rohitvijayakumar45/ShelfFlow/reports/cam-640x480-final.jpg

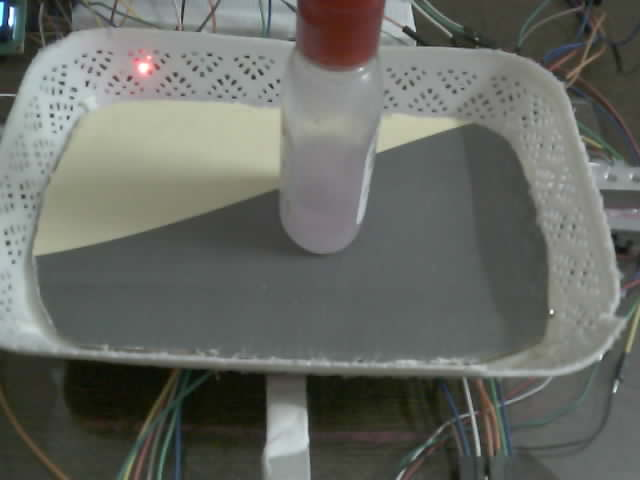
reports/cam-640x480-final.jpg
