rohitvijayakumar45/ShelfFlow/reports/cam-perfboard.jpg

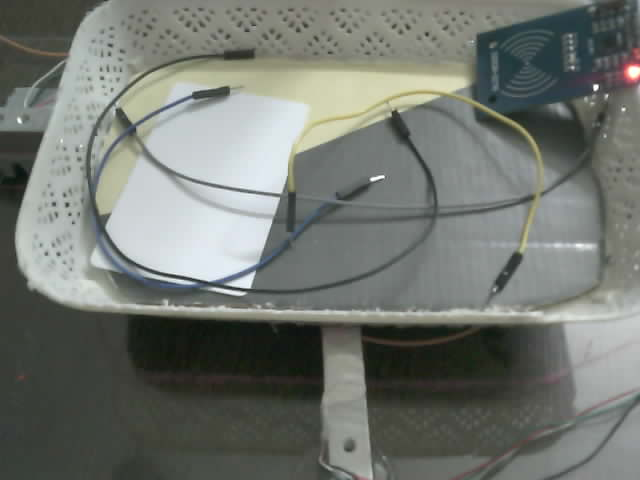
reports/cam-perfboard.jpg
