rohitvijayakumar45/ShelfFlow/firmware/gate-controller/include/README.md

Copy ../../common/Secrets.example.h here as secrets.h. Gate mechanism, voltage levels, actuator supply and feedback must be inspected before connection.
