rohitvijayakumar45/ShelfFlow/firmware/shelf-controller/include/README.md

Copy ../../common/Secrets.example.h here as secrets.h and configure credentials. This file contains no real credentials. The separate proposed controller mapping is documented in docs/wiring.md.
