rohitvijayakumar45/ShelfFlow/requirements-gpu.txt

# Install into the project venv with pip -r requirements-gpu.txt.
# Official Windows CUDA 12.8 wheels; run tools.dataset.gpu_check after installation.
--index-url https://download.pytorch.org/whl/cu128
torch==2.10.0+cu128
torchvision==0.25.0+cu128
