rohitvijayakumar45/ShelfFlow/docs/HANDOFF-2026-10-26.md

# Handoff: 26 October 2026 (night session, Aditya's laptop)

Read this first, then [HANDOFF-2026-10-25-laptop2.md](HANDOFF-2026-10-25-laptop2.md) (setup, hardware, start
commands) and [HANDOFF.md](HANDOFF.md) (hardware, weighing, camera history). Passwords, Wi-Fi keys and device keys
are **not** in git; the user has them in a separate file (`ShelfFlow-secrets-2026-10-26.txt`, kept outside the repo).

## Rules the user set (keep following them)

- **Do not change hardware/firmware/load-cell/RFID code. Do not flash anything without telling the user first.**
- The user does everything through the **staff (5174) and customer (5173) websites, never the terminal**. Claude
  starts/restarts services itself (from the `ShelfFlow` folder, not its parent) and checks they answer.
- **Never restart the trainer while a SAM/YOLO job runs.** Check `/status` of the trainer (port 8001) first.
- Answer fast and plainly; do not guess ("don't hallucinate"); change code only when asked.
- Installs stay inside the project folder; big downloads resumable + hash-checked.

## State when this session stopped

- Tests: **241 passed** (`.\.venv\Scripts\python.exe -m pytest -q`). Both apps build (`cd apps; node build.mjs`).
- Running services (terminal tabs): backend, camera_preview, usb_bridge (COM7), trainer, detector_preview,
  weight_monitor, camera_watch. **The vision service (`tools.local_app vision`) was NOT running** at the end; it
  stopped by itself earlier. Start it again with `.\.venv\Scripts\python.exe -m tools.local_app vision`.
- No training job running. Last run `20261026-005450` finished.

### Trained models (Train products page, YOLO26n, chained)

Each run builds on the one before it (parent = model in use) and keeps its products:

| Run | Knows | Parent |
|---|---|---|
| 20261025-234004 | sanitizer | (fresh start) |
| 20261025-235955 | + vicks | 234004 |
| 20261026-000926 | + sunscreen | 235955 |
| 20261026-002045 | + hair-care (Hair Wax) | 000926 |
| 20261026-003817 | + powder (Banana Powder) | 002045 |
| **20261026-005450 (in use)** | + nose-drops (Nose Drops): 6 products, mAP50 99.5 % | 003817 |

Recordings (all LABELLED): empty tray (81 frames), sanitizer, vicks, sunscreen, hair-care, powder, nose-drops.
Catalogue (store DB): sanitizer, vicks, sunscreen, hair-care, powder, nose-drops (Nose Drops was added this session).
**Models, recordings and the database are git-ignored** (`models/`, `data/`): they exist only on this laptop
(`models/` 289 MB, `data/` 3 GB incl. `data/training` 189 MB). Back them up by copying those folders.

The validation mAP is optimistic (val frames come from the same clips). Real check: Train page → Test live.

## What was built this session (all in this commit)

1. **Model lineage** (`vision/training.py`, `tools/trainer.py`): a new run inherits the dataset frames and weights
   of the model in use, so it always knows every product trained before, even if their recordings are deleted.
   `POST /train` takes `parent` ("" = fresh). Train page shows "Builds on the model in use, which knows … Adds …".
   **Stop using** button (`POST /runs/{id}/deactivate`) lets you delete the model in use and start from scratch.
   Epochs: free number input (1–300). Training stops early on its own (patience ≈ epochs/3, ≥ 10); Stop keeps the best.
2. **Unknown check** (`vision/verify.py`): every YOLO detection is compared (DINOv2 cosine similarity) with reference
   crops of the product YOLO named, cut from that model's own training frames; too dissimilar → UNKNOWN.
   References are built automatically at the end of each training (`run/best-refs.npz`) and copied to
   `models/trained/active-refs.npz` on "Use this model" (built on the spot for older runs). Per-product threshold =
   5th percentile of the product's own validation similarity, clamped to [0.55, 0.75]. Used in the live view
   (`tools/detector_preview.py`), Test live (`tools/trainer.py`) and the shop (`vision/run.py`, averaged per track
   via `TrackCheck`). No references file → no check (old behaviour). Measured on the sanitizer-only model:
   own frames kept 47/50; old-camera Vicks 51/59 and Sunscreen 58/59 rejected.
3. **Earlier-system import** (`tools/import_pilot_training.py`): turns `data/shelf-pilot` (16 Oct hand-labelled
   frames of sanitizer/vicks/sunscreen + 25 Oct empty-tray frames) into Train-page recordings. The user later
   deleted those imported recordings and retrained everything from their own clips; the tool stays for reuse.
4. **Full shop workflow, part 1** (tested, NOT yet switched on):
   - **Strict auto-add** (`backend/config.py` `AUTO_ADD`, `backend/service.py` `timely_weight_source`): in hardware
     mode a camera event may update the cart without staff review when it cites exactly one shelf WEIGHT event
     that the laptop received during the camera window (stands in for the shelf's second-accurate clock), AND every
     existing fusion check passes (one owner via bracelet marker, hand-product-trajectory chain, weight matches a
     unit, vision agrees with weight, stock, single-use sensor evidence, two-shopper ambiguity → review).
     Off by default; needs `AUTO_ADD=true` and `WEIGHTS_ENABLED=true` in `data/integration/runtime.env` + backend restart.
     Tests: `backend/tests/test_auto_add.py`.
   - **Bracelet bands as identity** (`vision/hands.py` `split_bands`, `band_evidence`; wired in `vision/run.py`):
     YOLO classes `band-stripe` / `band-circle` are removed from the product list and become bracelet markers
     **200 (Stripes)** / **201 (Circles)**; the area around a band (3× its box, `band_hand_reach` in vision-config)
     acts as that wrist's hand. Existing marker → bracelet → session mapping then names the customer.
     Tests: `vision/tests/test_bands.py`.
   - **Sensor health**: the controller reports `ok=false` forever once its queue overflowed since boot (historical
     count, 67 at the end). Vision now treats the sensor as healthy unless that count grows during a pickup or
     there are fault flags (`SENSOR_QUEUE_LOST_EVENTS`). A controller reset (RST button, not a flash) clears it.
   - **Check-in** (`POST /staff/check-in/preview`, `POST /staff/check-in`; staff app Shoppers & checkout →
     Check-in & bracelets): scan the customer's entry QR → tap the bracelet on a shelf RFID reader → "Assign and
     start visit". Consumes the QR once, refuses unregistered / busy / pattern-less bracelets, one bracelet per visit.
   - **Bracelet register** form with pattern (Stripes/Circles) and "Use latest tap"; table shows pattern + wearer.
     The old dispenser/manual assignment moved into a collapsed "Bracelet dispenser (simulated gate)" panel.
   - **Train page**: "Bracelet with stripes" / "Bracelet with circles" in "What are you recording?" (classes
     band-stripe / band-circle; never charged).
   - **Staff exit backend** (`POST /staff/exit`, `GET /staff/visits/{id}`, `service.staff_exit`): one payment key per
     visit (`exit-<session>`), so repeats return the same bill; blocked while pickup/return events are pending.
     Customer cart now includes the bracelet's markers.

## NOT finished (next steps, in order)

1. **Exit screen in the staff app and customer "go to the exit" text**: written but NOT applied. Apply with
   `.\.venv\Scripts\python.exe docs\pending\exit-checkout-ui-patch.py` from the ShelfFlow folder, then
   `cd apps; node build.mjs`. Check the `fetch('/api/staff/visits/…')` URL matches how the staff app proxies the
   backend (other calls use `/api/...`); then delete `docs/pending/`.
2. **Register the bracelets**: only B01 (tag `43D51829`, state RETURNED, no pattern) exists. Staff app →
   Shoppers & checkout → Bracelet inventory → Register or relabel: B01 = one pattern, B02 = the other (tap it, "Use
   latest tap"), Cleaned ticked.
3. **Train the bands** on the Train page (user planned this): record each bracelet worn on a hand moving over the
   tray, mark it, Train (builds on the 6-product model), Use this model. Check in the live view that bands are boxed.
4. **Unit weights / stock**: tray-a is unit-tracked; every product still has no measured weight and stock is 0.
   Load units with the tray-loading wizard (Shelf setup) so each unit's weight is recorded.
5. **Switch on**: `WEIGHTS_ENABLED=true`, `AUTO_ADD=true` in runtime.env, restart backend and vision; then a full
   physical trial: check-in → pickup → cart + stock update → return → exit → bill → bracelet return.
   Tune `band_hand_reach` if pickups are not linked to the band.
6. Exit is "staff check-out" (user's choice); there is no exit hardware. Payment stays SIMULATED (no provider).
7. Two shoppers on one tray: weight-driven path only links a band when exactly one item track moved; otherwise the
   event goes to review (by design, never charge an arbitrary customer).
8. Clean-up: review queue items; old junk runs were already deleted by the user.

## Camera problems (to troubleshoot next, user's request)

- **Short drops**: `tools.camera_watch` (log `data/logs/camera-watch.jsonl`) saw the camera vanish for ~9 s about
  every 10–30 min (22:47 → 01:08, 14 times), every time "STAYED RUNNING, was off the network" (uptime kept growing),
  i.e. Wi-Fi/hotspot drops, not reboots/brownouts.
- **Start-up failures** (intermittent, earlier): see HANDOFF.md section 8 and the 25 Oct laptop2 handoff. The COM9
  brownout loop is most likely the **programmer** board, not the camera. Fit the 100 µF capacitor at the camera
  5V/GND; read the camera's own boot log with EN→GND on the programmer: `tools.camera_serial_log --port COM9`.
- **Add the Pixel hotspot** as a second network (firmware already rotates through up to 3 SSIDs every 15 s):
  needs (a) a short PlatformIO path (junction `C:\pio` → `.platformio-core`, `PLATFORMIO_CORE_DIR=C:\pio`; long
  paths exceed Windows' command-line limit), (b) `WIFI_SSID_2 "Pixel"` / `WIFI_PASSWORD_2` in
  `firmware/camera/include/secrets.h` (keep CAMERA_KEY unchanged; values in the user's secrets file),
  (c) programmer EN→GND jumper, hold camera IO0→GND while tapping RST, (d) `esptool read_mac` must show
  `68:09:47:F8:93:B8` before upload. **Tell the user before flashing.**

## Hardware/network quick facts

Hotspot **X200T** (laptop + camera). Camera `10.12.94.251`, MAC `68:09:47:F8:93:B8`, OV3660, 320×240 ~11 fps.
Shelf controller **COM7**, programmer **COM9**. Tray-a calibration `ac2-167a4d-8q`. GPU RTX 4050, CUDA torch 2.10.

## Files outside git the next session needs (all on this laptop)

`data/integration/runtime.env` (+ `.old-system`), `data/integration/vision-config.json`, `data/integration/store.db`,
`.env`, `firmware/camera/include/secrets.h` + `board_config.h`, `firmware/shelf-controller/include/secrets.h`,
`models/` (trained models, references, YOLO/SAM weights), `data/training/` (recordings and runs),
`data/hardware-backups/`, `handoff-secrets/` (copies of the secret files; never commit it).
Their secret contents are in the user's secrets file.

## Moving to a new system (checklist)

1. `git clone` / pull `main`. Unzip `ShelfFlow-local-data-2026-10-26.zip` into the ShelfFlow folder (adds `models/`,
   `data/`, `evidence/`, `shelfflow.db`, `.env`, `handoff-secrets/`, firmware `secrets.h` / `board_config.h`).
   Replace `data/integration/store.db` with `ShelfFlow-store-snapshot-2026-10-26.db` (consistent copy).
2. Edit the absolute paths in `data/integration/runtime.env` to the new folder.
3. Reinstall what is not copied (see HANDOFF-2026-10-25-laptop2.md "Setup"): `.venv` with `pip install -e .[test,vision,hardware]`
   (+ CUDA PyTorch if there is an NVIDIA GPU), `cd apps; npm install`, PlatformIO only if firmware must be built.
4. Needs internet once: the Unknown check downloads `facebook/dinov2-small` (~90 MB) into the Hugging Face cache
   (outside the project) on first use.
5. COM ports differ per machine: find the shelf controller's port and pass it to `tools.usb_bridge --port`.
   The laptop must join hotspot X200T to reach the camera at 10.12.94.251.
6. Start the services (commands in HANDOFF-2026-10-25-laptop2.md) and check the Train page shows run
   20261026-005450 as "in use" with 6 products.
