rohitvijayakumar45/ShelfFlow/docs/audit-2026-10-12.md

# Requirements audit — 12 October 2026

Scope: the whole repository at commit `1d0e93c` plus the fixes listed below, checked against the
original ShelfFlow specification (sections 1–14). Hardware context: one ESP32-S camera board with
OV3660, one ordinary ESP32 used as the programmer instead of a USB-TTL adapter, and one RC522.

Legend: **PASS** = implemented and exercised by automated tests or builds in this audit.
**PARTIAL** = implemented, but a stated part is missing or only simulated. **OPEN** = requires physical
hardware or data that does not exist yet. Nothing here is physically verified.

## What was re-run in this audit

| Check | Result |
|---|---|
| `pytest` (backend + vision) | **68 passed** (66 existing + 2 new regression tests), 1 third-party deprecation warning |
| `firmware/programmer` build | SUCCESS |
| `firmware/shelf-controller` build | SUCCESS (RAM 45,736 B, flash 856,337 B) |
| `firmware/gate-controller` build | SUCCESS |
| `firmware/camera` — `unconfigured-diagnostic`, `camera-api-check` | SUCCESS |
| `firmware/camera` — new `esp32cam-identify`, `esp32cam-pinmap-probe`, `esp32cam` | SUCCESS |
| Real camera server built for `esp32cam` with candidate map as a temporary `board_config.h` | SUCCESS (flash 859,393 B), temp file removed |
| Generated camera upload command | Verified: `--baud 115200 --before no_reset --after no_reset`, offsets 0x1000/0x8000/0xe000/0x10000 |
| `import vision.run, vision.benchmark` | OK |
| Docker Compose, PostgreSQL, Mosquitto, RQ | **Not run** — Docker unavailable (unchanged from status.md) |
| Any flashing, wiring, sensor reading | **Not done** — no hardware attached to this PC |

## Defects found and fixed

| # | Severity | Finding | Fix | Verification |
|---|---|---|---|---|
| F1 | High | Sensor firmware publishes HEALTH live every 500 ms, each consuming a sequence number, while BARRIER/WEIGHT/RFID drain later from the flash queue. Backend treated any lower sequence as late, so a sensor **flush barrier could never be acknowledged** and exit reconciliation always looked incomplete. | `backend/service.py`: HEALTH no longer advances or is judged against the per-boot ordering watermark; durable events still are. | New tests `test_best_effort_health_does_not_make_queued_barrier_late` (failed before fix, passes after) and `test_durable_event_ordering_still_rejects_older_barrier` |
| F2 | Medium | Device flash queue sent the first file in LittleFS name order — lexicographic, so `…-10.json` went before `…-9.json`, producing avoidable out-of-order events. | `firmware/common/Device.h` now sends the lowest queued sequence first. | Shelf + gate builds |
| F3 | Medium | `vision/run.py` Mode B called `/mode?high=0` on **every loop iteration** while idle (doubling camera HTTP load) and an HTTP error from a resolution switch outside the per-frame `try` would terminate the vision process. | Switch only on state change; failures are recorded on the active collection and never fatal. | Import check, full test suite |
| F4 | Medium | No usable procedure for flashing the camera through the spare ESP32: no download-mode confirmation, no power guidance, no protection against esptool silently writing camera firmware **into the programmer**, no way to identify the carrier. | Rewrote [programming-camera.md](programming-camera.md) (two methods, wire tables, meter checks, loopback tests, MAC safety check). Added `esp32cam-identify` (chip/flash/PSRAM/MAC, no camera pins) and `esp32cam-pinmap-probe` (accepts the AI-Thinker candidate map only after reading OV3660 PID 0x3660 **and** a JPEG). | Builds + upload command inspection |
| F5 | Low | Camera server never reported its IP address, so the user could not find `CAMERA_URL`. | Prints `WIFI_CONNECTED ip=… rssi=… ov3660=ok|FAILED` and `WIFI_LOST`. | Build |
| F6 | Low | Shelf controller produced no local output, so RC522 / HX711 could not be brought up without the full backend + broker. | 1 Hz `DIAG raw tray-a=… tray-b=… rc522_version=0x.. wifi mqtt fs` line and `DIAG RFID uid=…`. New [sensor-controller-bringup.md](sensor-controller-bringup.md). | Build |
| F7 | Low | Opening a serial monitor could reset the programmer (DevKit auto-reset), breaking Method B mid-session. | `monitor_dtr = 0`, `monitor_rts = 0` in programmer and camera PlatformIO environments. | Build |

## Open findings (not fixed — need a decision or hardware)

| # | Finding | Recommendation |
|---|---|---|
| O1 | **Hardware inventory gap.** The design needs a 2nd ESP32 (gate controller) and a 2nd RC522 (gate UID read) in addition to the items reported; also 2× HX711, 2× four-wire load cells, servo, release beam, position switch, and a 5 V ≥ 2 A camera supply. | Buy before gate demo. Until then the gate runs in simulation / audited manual assignment (already implemented). |
| O2 | Sensor HEALTH events (2 trays × 2 Hz) are each stored as `sensor_events` rows with an outbox ACK — about 345 k rows/day, never pruned. | Lower firmware HEALTH rate (e.g. 5 s) or add a retention job for HEALTH rows. Not changed: affects the device-health UI cadence. |
| O3 | Firmware clock is NTP whole seconds, `clock_synced=false`, 1000 ms uncertainty, so physical fusion always vetoes `CLOCK_UNCERTAINTY`. | Implement camera/sensor offset calibration (documented as remaining work). Physical mode stays review-first. |
| O4 | No explicit task watchdog configuration in firmware (loops are non-blocking and yield, i.e. watchdog-*compatible*, but a hung SPI/HTTP call is not reset). | Add `esp_task_wdt` subscription to `loop()` after physical timing is measured. |
| O5 | Optional status LED on GPIO27 is in the BOM/pin map but not driven by firmware. | Cosmetic; implement when hardware exists. |
| O6 | Camera transport is authenticated JPEG polling; no MJPEG stream on the camera firmware. | Spec says "MJPEG where supported" — acceptable; dataset `mjpeg` tool targets an external endpoint. |
| O7 | MQTT is cleartext with the device key inside the payload; firmware TLS not implemented. | Prototype LAN only (documented in security.md). |
| O8 | Camera carrier pin map is still unconfirmed. | Run `esp32cam-pinmap-probe`; only `PROBE_PASS pid=0x3660` permits creating `board_config.h`. |

## Requirement matrix

| § | Requirement | Verdict | Evidence / gap |
|---|---|---|---|
| 1 | One OV3660 camera only; no extra cameras/UWB/active bracelets | PASS | BOM and code use one camera; gate scanning uses browser camera |
| 1 | No shelf tap / activation button / customer window | PASS | No such endpoint/UI; RFID/weight/motion only trigger evidence (`vision/run.py trigger`) |
| 1 | Concurrent shoppers, ambiguous → pending, no guessed charges | PASS (simulated) | Fusion veto tests; hardware mode always review-first |
| 1 | Bracelet-hand limitation displayed honestly | PASS | Customer + staff UI text |
| 2 | FastAPI/Pydantic, PostgreSQL/SQLAlchemy/Alembic, Redis/RQ, Mosquitto, React/TS/Vite PWA, WS, OpenCV/Ultralytics, PlatformIO, Compose; no Mongo/Express | PASS (Compose unexecuted) | pyproject/package.json pins; Compose not run |
| 3 | Do not assume AI-Thinker OV2640 config; no invented pins | PASS | Candidate map isolated in `candidates/`, gated by electrical PID+JPEG probe |
| 3 | Separate ESP32 for RFID + HX711; RC522 short range documented | PASS | wiring.md, sensor-controller-bringup.md step 1.7 |
| 3 | Separate actuator supply, no mains | PASS (doc) | wiring.md |
| 4 | Opaque single-use QR, atomic consume, reserve, idempotent dispense, UID + release + position verify, jam/timeout/wrong UID/duplicate/lost ACK/reboot, states, audited manual assign, return/cleaning, no reuse with unresolved events | PASS (simulated) | test_store / test_recovery; gate firmware state machine compiles; physical OPEN |
| 5 | Diagonal placement drawing + visibility procedure | PASS (doc) | placement.svg, validation.md |
| 5 | Mode A / Mode B benchmarkable, measure switch delay/gaps/age/latency/blur | PARTIAL | `vision.benchmark` implemented; **no measurements yet** |
| 5 | Rolling buffer, pre/post evidence, no destructive flush, stale-frame detection, Wi-Fi reconnect, bounded queues | PASS (unit tests) | capture.py, test_buffer/test_capture |
| 5 | Full-res marker decode, crop-based detection, documented transforms | PASS | run.py, association.py, setup.md |
| 6 | OpenCV ArUco generation, session↔bracelet↔UID↔markers, no colour identity, no per-customer class | PASS | markers.py, BraceletBinding |
| 6 | Ownership needs marker→wrist→grasp→trajectory→weight; RFID corroborates only | PASS (rules) / OPEN (extractor) | Fusion vetoes; real extractor is review-first by design |
| 7 | Custom YOLO26 detector, yolo26n/s benchmarking, optional pose, MOCK/MODEL_UNAVAILABLE | PARTIAL | Tooling present; **no dataset or weights** |
| 7 | Joint multi-candidate evaluation, no double assignment, zero-net exchange observed | PASS (simulated) | Fusion + SensorClaim tests |
| 8 | Tare/known-mass calibration, noise, settling, hysteresis, drift/overload/disconnect/stuck | PARTIAL | Firmware lacks drift (Python processor has it) — documented |
| 8 | Separate evidence dimensions, vetoes before aggregation, atomic cart+inventory, returns need matching cart, handoff stays with picker | PASS | fusion.py, service.py, tests |
| 9 | Versioned envelope fields, duplicate/out-of-order/reboot handling, app-level durable ACK, bounded persistent queue, outbox, cart versions + snapshot | PASS (F1/F2 fixed) | schemas.py, Device.h, tests |
| 9 | Measured cross-device timing offsets | OPEN | O3 |
| 10 | Full data model, customer/staff apps, simulated payment w/ idempotency, exit reconciliation, late-event corrections, egress never blocked | PASS (simulated) | models.py, App.tsx, tests |
| 11 | Dataset tools (capture, MJPEG, metadata, weight trace, extraction, dedupe, validation, grouped split, train/eval/export, replay) + beginner guide | PASS (tools) / OPEN (data) | tools/dataset/cli.py, dataset.md |
| 12 | Buildable firmware, non-blocking, safe startup, timeouts, diagnostics, persistent config, backoff | PASS (build) | All envs build; watchdog O4 |
| 12 | wiring.md with BOM, pin tables, power, grounds, load cells, flashing for actual carrier, multimeter checks, bring-up | PASS (after F4/F6) | wiring.md + programming-camera.md + sensor-controller-bringup.md |
| 13 | Server-owned prices/state, authz, device auth, ACLs, schema validation, replay protection, rate limits, retention | PASS (prototype) | security.md; TLS O7 |
| 14 | Vertical slice QR→bracelet→pickup→cart→return→pay→receipt via same fusion interface | PASS | simulator/demo.py, http-demo.txt |
| 14 | Separate physical metrics (precision/recall, ownership, false charges, latency…) | OPEN | reports/physical-metrics.json keeps them null, which is correct |

## Next physical steps (in order)

1. [programming-camera.md](programming-camera.md) stages 1–8 → record chip/PSRAM, get `PROBE_PASS`.
2. Stage 9 → camera on Wi-Fi, run Mode A/B benchmarks into `reports/`.
3. [sensor-controller-bringup.md](sensor-controller-bringup.md) → RC522 read-zone map, both trays calibrated, cross-talk measured.
4. Mount camera per placement.svg; record 20–30 interactions; human ownership review ([validation.md](validation.md)).
5. Buy O1 items before any gate/dispenser demonstration.
