rohitvijayakumar45/ShelfFlow/reports/cam-480x320-q12.jpg

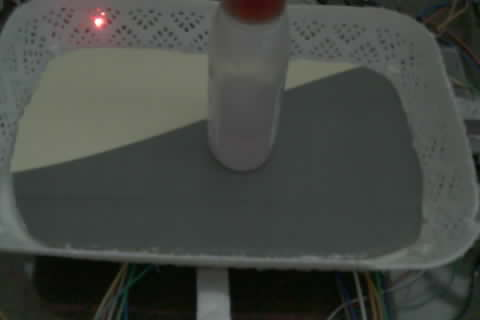
reports/cam-480x320-q12.jpg
