rohitvijayakumar45/ShelfFlow/reports/cam-640x480-q10.jpg

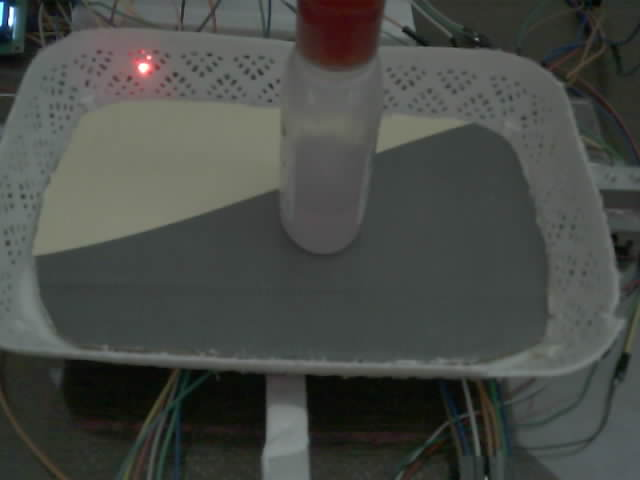
reports/cam-640x480-q10.jpg
