rohitvijayakumar45/ShelfFlow/reports/camera-check-20261025.jpg

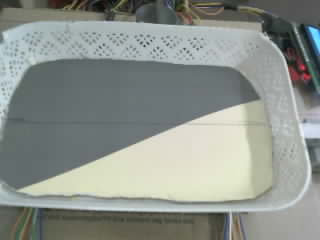
reports/camera-check-20261025.jpg
