rohitvijayakumar45/ShelfFlow/reports/customer-mobile.jpg

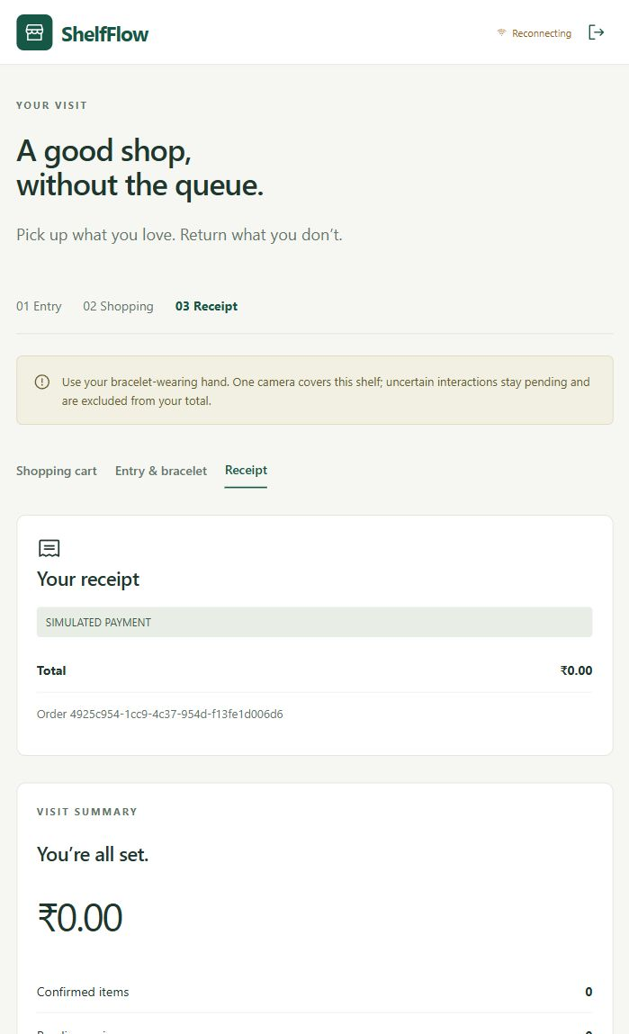
reports/customer-mobile.jpg
