rohitvijayakumar45/ShelfFlow/reports/customer-receipt.jpg

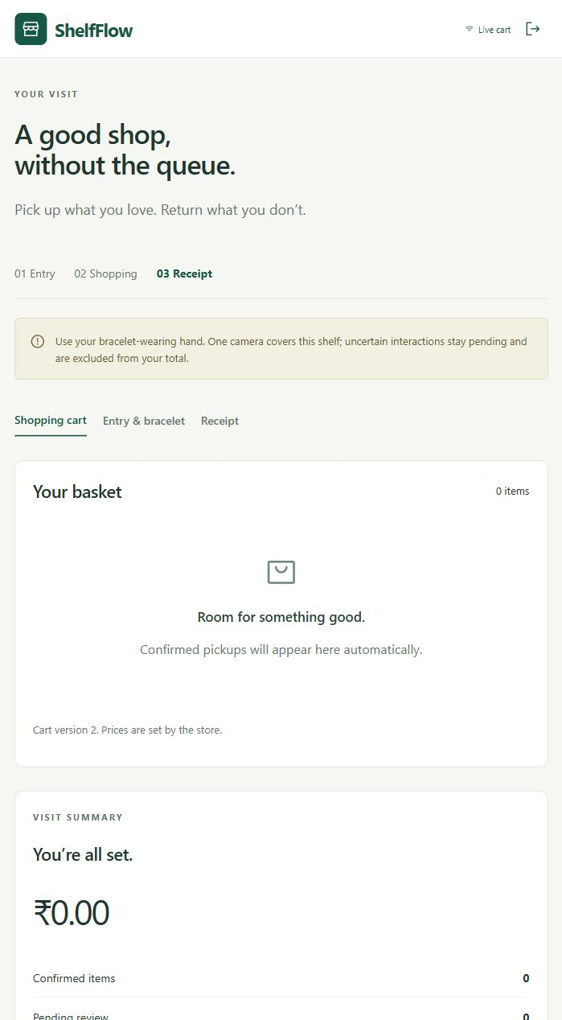
reports/customer-receipt.jpg
