rohitvijayakumar45/ShelfFlow/reports/first-frame-shaun.jpg

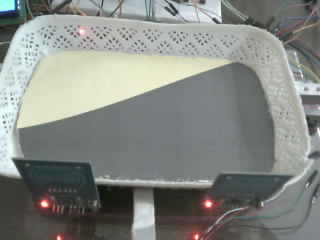
reports/first-frame-shaun.jpg
