rohitvijayakumar45/ShelfFlow/reports/first-frame.jpg

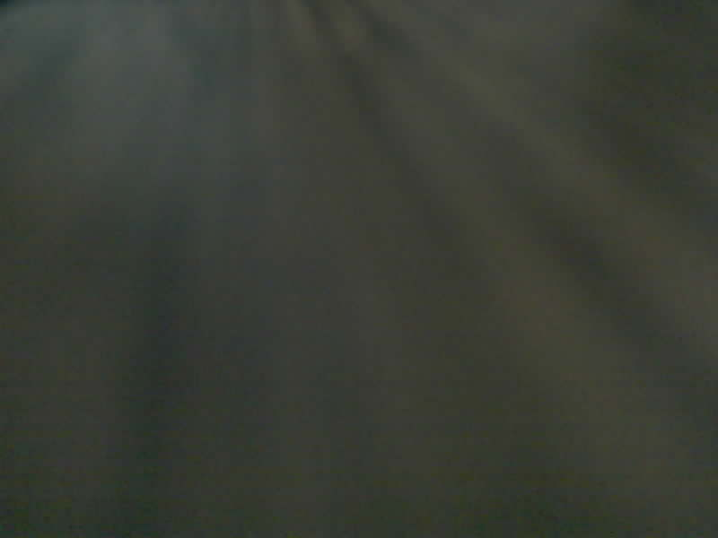
reports/first-frame.jpg
