rohitvijayakumar45/ShelfFlow/reports/roi-grid.jpg

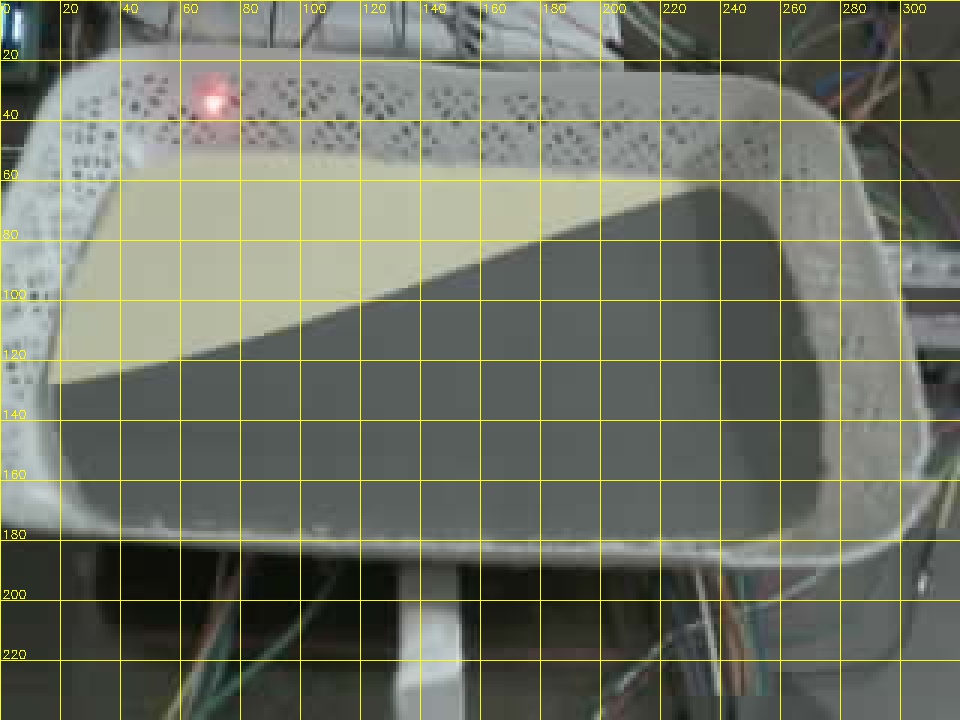
reports/roi-grid.jpg
