rohitvijayakumar45/ShelfFlow/reports/staff-overview.jpg

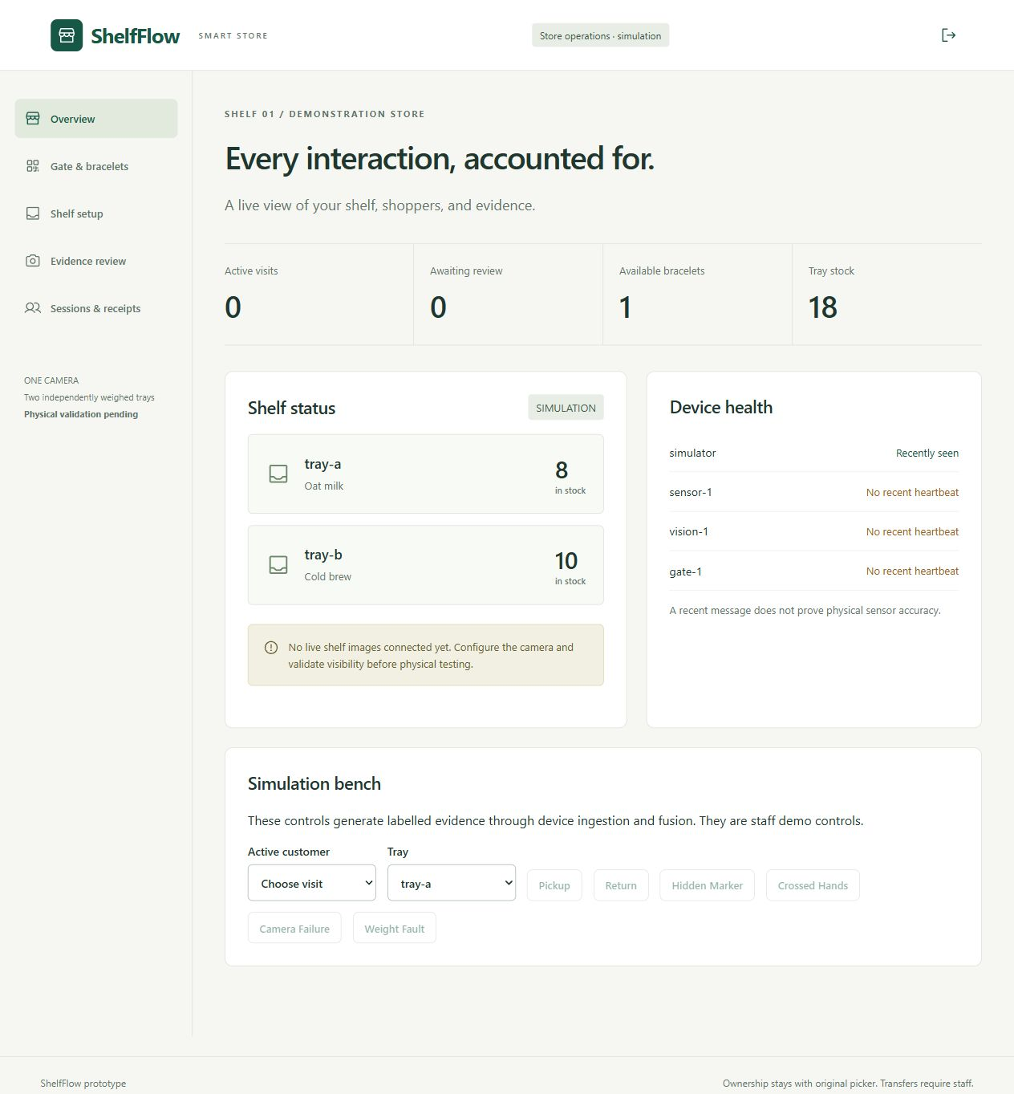
reports/staff-overview.jpg
