rohitvijayakumar45/ShelfFlow/docs/perfboard/ShelfFlow-perfboard-guide.html

# ShelfFlow perfboard build guide

Shelf controller (ESP32 #1), three HX711 load-cell amplifiers, two RC522 readers, LCD and buttons, ESP32-CAM and its programmer (ESP32 #2). Board 55 × 37 pads, 2.54 mm pitch. Pins match the running firmware (firmware/shelf-controller, build devkitc-v4-usb-integration).

How the layout saves work. Pins that share a connection are placed next to each other, so one straight bare wire (a bus) or a solder bridge joins them:

- Three rails in neighbouring rows (R1 5V, R2 GND, R3 3V3). Capacitors sit straight across two rails: no wires.
- HX711s side by side with their headers on the same rows: one bus powers all three GND pins (R8), one all three VCC pins (R11).
- RC522 headers back to back (C20 | C21): the six shared pins are joined by solder bridges.
- One 6-pin UI header for the LCD and both buttons, with a single GND pin.
- ESPs are not on the board. Female dupont ends go on the ESP pins; the other end is soldered to the pad shown.
- Camera flashing never touches the board: those links run ESP to ESP, only while flashing.

### Contents

1. Schematic, true scale (print at 100 %)
2. Schematic, enlarged
3. Parts and pad positions
4. Pinouts
5. All connections
6. Before you start
7. Build order with checks
8. Inspection before power
9. Power-up and tests
10. Recalibration
11. Troubleshooting
12. Tick list

### Key

5 VGND3.3 VHX711 data/clockRC522 bus / selectLCD and buttonscamera

Bare = tinned copper wire or solder bridge on the solder side (thick line).
Insulated = hook-up wire, allowed to cross other wires and rails (dashed line).
C20R23 = column 20, row 23, counted from the top-left corner, component side up.
n.n → ESP pin = a wire to an ESP; n.n is its step number in this guide.

Never: 5 V on an RC522, HX711 VCC or the 3V3 rail · power on while soldering · connect ESP-CAM 3V3/VCC or ESP #2 VIN · bridge RC522 pin 1 (SDA) or pin 5 (IRQ) between R1 and R2 · run bare wire along the HX711 DT (R9) or SCK (R10) rows.

## 1. Schematic, true scale: print at 100 % ("Actual size"), lay it on the board

Component side up. Rails, buses and bridges are on the solder side. If your print isn't exactly 2.54 mm between dots, reprint with scaling switched off. The HX711 boards sit raised on their headers above the rail and bus rows; the bare wires underneath stay clear.

## 2. Schematic, enlarged for reading

## 3. Parts and pad positions

All positions are on the component side. The HX711 header is on the module's short edge; its body extends to the left of the header column, and its load-cell pads (E+, E−, A−, A+) are at the far left end.

Part | What | Pads
J0 | 2-pin screw terminal, 5 V in | + C1R1, − C1R3
HX711 A | soldered by its 4-pin header (header on the module's right edge) | GND C15R8 · DT C15R9 · SCK C15R10 · VCC C15R11
HX711 B | same | GND C29R8 · DT C29R9 · SCK C29R10 · VCC C29R11
HX711 C | same | GND C43R8 · DT C43R9 · SCK C43R10 · VCC C43R11
R1 header | 8-pin male header, reader cable plugs in | column C20, SDA C20R22 … 3V3 C20R29
R2 header | 8-pin male header right next to R1 | column C21, SDA C21R22 … 3V3 C21R29
UI header | 6-pin male header: GND, VCC, SDA, SCL, PAGE, ACTION | row R28, C38R28 … C43R28
C1 | 100 µF, near the ESP #1 power wires | − C33R2 (GND rail), + C33R3 (3V3 rail)
C2 | 100 µF, near the camera power wires | + C53R1 (5V rail), − C53R2 (GND rail)
C3 | 10 µF, at the RC522 block | − C22R27, + C22R29

Check your HX711 header order. This layout assumes the silkscreen reads GND, DT, SCK, VCC from top to bottom. If yours reads differently (for example VCC, SCK, DT, GND), rotate all three modules the same way so GND lands on R8 and VCC on R11, or move the two buses to the rows where GND and VCC actually are. The DT and SCK pads in the tables move with them.

RC522 cable order. Both headers are pin 1 (SDA) at the top (R22) and 3V3 at the bottom (R29), the same order as the pins on the reader module. Plug each reader cable so that the reader's SDA wire lands on R22.

## 4. Pinouts

### ESP32 DEVKIT V1, 30-pin (ESP #1 shelf controller and ESP #2 programmer)

Component side up, antenna at the top, USB at the bottom; pins counted from the top. Some boards print RX2/TX2 as D16/D17. Clone boards vary, so go by the printed labels. D34 is input-only, so it must be HX711 C DT.

# | Left pin | ESP #1 use | Right pin | ESP #1 use

1 | EN | (ESP #2: to GND while flashing) | D23 | RC522 MOSI
2 | VP 36 | – | D22 | RC522 RST
3 | VN 39 | – | TX0 | (ESP #2: to camera U0T)
4 | D34 | HX711 C DT | RX0 | (ESP #2: to camera U0R)
5 | D35 | – | D21 | RC522 R1 SDA (select)
6 | D32 | HX711 A DT | D19 | RC522 MISO
7 | D33 | HX711 A SCK | D18 | RC522 SCK
8 | D25 | HX711 B DT | D5 | –
9 | D26 | HX711 B SCK | TX2 (17) | LCD SCL
10 | D27 | HX711 C SCK | RX2 (16) | LCD SDA
11 | D14 | ACTION button | D4 | RC522 R2 SDA (select)
12 | D12 | – (boot pin: never use) | D2 | –
13 | D13 | PAGE button | D15 | –
14 | GND | GND (one wire) | GND | – (joined inside)
15 | VIN | 5 V in | 3V3 | 3.3 V out → 3V3 rail

### ESP32-CAM

Lens up, pins at the bottom.

Row 1 | Use | Row 2 | Use
5V | 5V rail | 3V3 | never connect
GND | GND rail | IO16 | –
IO12 | – | IO0 | jumper to the GND pin below it, only while flashing
IO13 | – | GND | (the jumper's other end)
IO15 | – | VCC | never connect
IO14 | – | U0R | ESP #2 RX0 (flashing only)
IO2 | – | U0T | ESP #2 TX0 (flashing only)
IO4 | – | GND | –

### HX711

Logic: GND · DT · SCK · VCC (read your silkscreen).
Cell side: E+ · E− · A− · A+; B−/B+ unused.

### RC522

SDA · SCK · MOSI · MISO · IRQ · GND · RST · 3.3V
3.3 V only.

### UI header (R28, left → right)

GND · VCC · SDA · SCL · PAGE · ACTION
Both buttons' second legs join the GND wire in the cable.

### LCD I2C backpack

GND · VCC · SDA · SCL. VCC on 3V3, as on the breadboard now. Use 5 V only if you measured that the backpack's SDA/SCL don't sit at 5 V.

## 5. All connections

### On the board (rails, buses, bridges, links)

Step | Net | From | To | Type
3.2 | 5 V | C1R1 | C3R1 | bare (solder side)
3.2 | GND | C1R3 | C3R2 | insulated wire
3.3 | GND | C15R8 | C43R8 | bare (solder side)
3.4 | 3.3 V | C15R11 | C43R11 | bare (solder side)
3.5 | GND | C16R8 | C16R2 | insulated wire
3.6 | 3.3 V | C43R11 | C44R11 | bare (solder side)
3.6 | 3.3 V | C44R11 | C44R3 | bare (solder side)
3.7 | RC522 bus / select | C20R23 | C21R23 | bare (solder side)
3.7 | RC522 bus / select | C20R24 | C21R24 | bare (solder side)
3.7 | RC522 bus / select | C20R25 | C21R25 | bare (solder side)
3.7 | GND | C20R27 | C21R27 | bare (solder side)
3.7 | RC522 bus / select | C20R28 | C21R28 | bare (solder side)
3.7 | 3.3 V | C20R29 | C21R29 | bare (solder side)
3.8 | GND | C21R27 | C22R27 | bare (solder side)
3.8 | 3.3 V | C21R29 | C22R29 | bare (solder side)
3.9 | GND | C20R27 | C18R2 | insulated wire
3.10 | 3.3 V | C20R29 | C19R3 | insulated wire
3.11 | GND | C38R28 | C37R2 | insulated wire
3.12 | 3.3 V | C39R28 | C40R3 | insulated wire

Step 3.7 = the six R1↔R2 bridges on rows R23, R24, R25, R27, R28 and R29. Rails: bare wire along R1, R2 and R3 from C3 to C55.

### Wires to the ESPs (female dupont on the ESP end)

Step | Board pad | ESP pin | Colour
4.1 | C32R1 | ESP #1 VIN | red
4.2 | C32R2 | ESP #1 GND | black
4.3 | C32R3 | ESP #1 3V3 | orange
4.4 | C15R9 | ESP #1 D32 | green
4.5 | C15R10 | ESP #1 D33 | white
4.6 | C29R9 | ESP #1 D25 | green
4.7 | C29R10 | ESP #1 D26 | white
4.8 | C43R9 | ESP #1 D34 | green
4.9 | C43R10 | ESP #1 D27 | white
4.10 | C20R23 | ESP #1 D18 | blue
4.11 | C20R24 | ESP #1 D23 | blue
4.12 | C20R25 | ESP #1 D19 | blue
4.13 | C20R28 | ESP #1 D22 | grey
4.14 | C20R22 | ESP #1 D21 | yellow SS1
4.15 | C21R22 | ESP #1 D4 | yellow SS2
4.16 | C40R28 | ESP #1 RX2 (16) | purple
4.17 | C41R28 | ESP #1 TX2 (17) | purple
4.18 | C42R28 | ESP #1 D13 | purple
4.19 | C43R28 | ESP #1 D14 | purple
4.20 | C52R1 | ESP-CAM 5V | red
4.21 | C52R2 | ESP-CAM GND | black

### Load cells (to each HX711's far end, copy the breadboard exactly)

Cell wire (typical colour) | HX711 pad
red | E+
black | E−
white | A−
green | A+

Cell A = left support, B = middle, C = right. A cell must stay on its own HX711: the calibration depends on it.

### Camera flashing only (off the board, female–female duponts)

From | To
ESP-CAM IO0 | ESP-CAM GND (the neighbouring pin)
ESP #2 EN | ESP #2 GND
ESP #2 TX0 | ESP-CAM U0T
ESP #2 RX0 | ESP-CAM U0R
ESP #2 GND | ESP-CAM GND

Remove all of them after flashing. Never connect ESP #2 VIN.

## 6. Before you start (30 min)

1. Baseline on the breadboard. Stop the USB bridge, then run .\.venv\Scripts\pio.exe device monitor -p COM3 -b 115200 --dtr 0 --rts 0. Save 10 DIAG raw … lines; expect rc522=0xB2/0xB2 and lcd=ok. Type calstatus and note the version.
2. Photograph the breadboard, especially the load-cell wires on each HX711.
3. Label with tape: load-cell cables A/B/C, HX711s A/B/C, readers R1 (left of the tray front) and R2 (right).
4. Print page 1 of the schematic at 100 % and check one 10-pad span measures 25.4 mm.
5. Power off: USB and the 5 V supply unplugged.
6. Kit: iron at 320–350 °C with a fine tip, 0.6–0.8 mm rosin-core solder, flux, multimeter with beep, cutters, stripper, tinned bare wire (rails and buses), insulated solid-core 22–24 AWG, an 8-pin male header ×2, a 6-pin male header, a 2-pin screw terminal, 100 µF ×2, 10 µF ×1, about 25 female-ended dupont wires, tape or cable ties.

## 7. Build order

Soldering rules.

- Heat pad and pin together for 2–3 s, then feed solder. You want a shiny cone.
- Modules and headers: solder one corner pin, check the part sits flat, then the rest.
- Bus: lay bare wire flat on the solder side along the row, and solder it to every pin pad on the row plus every 3–4 empty pads.
- Bridge: tin both pads, then add solder until the blobs merge (or lay a cut-off lead across both).
- After every joint, look for an unwanted bridge to the next pad. Clear it with wick, or by dragging a clean tip between the pads.

### Phase 1: place and mark (no solder) · 10 min

Lay the printed schematic next to the board. Mark the rail rows (R1 5V, R2 GND, R3 3V3) and every part outline with a marker on the component side. Dry-fit each part on its pads.

✔ All three HX711 headers line up on R8–R11 at C15, C29 and C43. The R1/R2 headers sit in C20/C21, R22–R29.

### Phase 2: solder the parts (not the ESPs) · 30 min

Step | Part | Pads | S | C
2.1 | HX711 A | C15 R8–R11 | ☐ | ☐
2.2 | HX711 B | C29 R8–R11 | ☐ | ☐
2.3 | HX711 C | C43 R8–R11 | ☐ | ☐
2.4 | R1 and R2 8-pin headers | C20 and C21, R22–R29 | ☐ | ☐
2.5 | UI 6-pin header | C38–C43, R28 | ☐ | ☐
2.6 | Screw terminal J0 | C1 R1 (+), C1 R3 (−) | ☐ | ☐

✔ Beep test: no two neighbouring pins of any part beep together.

### Phase 3: rails, buses, bridges, capacitors · 30 min

Step | Do this | Pads | S | C
3.1 | Three rails: bare wire along R1 (5V), R2 (GND), R3 (3V3) | C3 → C55 | ☐ | ☐
3.2 | J0 + to the 5V rail (bare); J0 − to the GND rail (insulated link) | C1R1→C3R1; C1R3→C3R2 | ☐ | ☐
3.3 | HX711 GND bus (bare) | R8, C15 → C43 | ☐ | ☐
3.4 | HX711 VCC bus (bare) | R11, C15 → C43 | ☐ | ☐
3.5 | GND bus → GND rail (insulated: it crosses the 3V3 rail) | C16R8 → C16R2 | ☐ | ☐
3.6 | VCC bus → 3V3 rail (bare) | C43R11 → C44R11 → up C44 to C44R3 | ☐ | ☐
3.7 | Six R1↔R2 bridges: SCK, MOSI, MISO, GND, RST, 3V3. Not R22 (SDA) or R26 (IRQ) | C20↔C21 on R23, R24, R25, R27, R28, R29 | ☐ | ☐
3.8 | C3 10 µF (− on R27, + on R29), bridged to C21 | C22R27, C22R29 | ☐ | ☐
3.9 | RC522 GND → GND rail (insulated) | C20R27 → C18R2 | ☐ | ☐
3.10 | RC522 3V3 → 3V3 rail (insulated) | C20R29 → C19R3 | ☐ | ☐
3.11 | UI GND → GND rail (insulated) | C38R28 → C37R2 | ☐ | ☐
3.12 | UI VCC → 3V3 rail (insulated) | C39R28 → C40R3 | ☐ | ☐
3.13 | C1 100 µF straddling GND (−) and 3V3 (+) | C33R2, C33R3 | ☐ | ☐
3.14 | C2 100 µF straddling 5V (+) and GND (−) | C53R1, C53R2 | ☐ | ☐

✔ Beep checks:

- 5V↔GND, 3V3↔GND and 5V↔3V3: silent.
- Every HX711 GND → GND rail, and every HX711 VCC and R1/R2 3V3 → 3V3 rail: beep.
- R1 pin ↔ R2 pin: beep on R23/R24/R25/R27/R28/R29, silent on R22 and R26.
- Nothing on R9 or R10 (DT/SCK) beeps to anything yet.
- Capacitor stripe (−) faces the GND rail.

### Phase 4: wires to the ESPs · 40 min

Solder one end to the pad listed, and put a female dupont on the other end. Label each one (e.g. D32). Cut them to length so the ESP #1 bundle stays under 20 cm.

Step | Board pad | ESP pin | Colour | S | C
4.1 | C32R1 | ESP #1 VIN | red | ☐ | ☐
4.2 | C32R2 | ESP #1 GND | black | ☐ | ☐
4.3 | C32R3 | ESP #1 3V3 | orange | ☐ | ☐
4.4 | C15R9 | ESP #1 D32 | green | ☐ | ☐
4.5 | C15R10 | ESP #1 D33 | white | ☐ | ☐
4.6 | C29R9 | ESP #1 D25 | green | ☐ | ☐
4.7 | C29R10 | ESP #1 D26 | white | ☐ | ☐
4.8 | C43R9 | ESP #1 D34 | green | ☐ | ☐
4.9 | C43R10 | ESP #1 D27 | white | ☐ | ☐
4.10 | C20R23 | ESP #1 D18 | blue | ☐ | ☐
4.11 | C20R24 | ESP #1 D23 | blue | ☐ | ☐
4.12 | C20R25 | ESP #1 D19 | blue | ☐ | ☐
4.13 | C20R28 | ESP #1 D22 | grey | ☐ | ☐
4.14 | C20R22 | ESP #1 D21 | yellow SS1 | ☐ | ☐
4.15 | C21R22 | ESP #1 D4 | yellow SS2 | ☐ | ☐
4.16 | C40R28 | ESP #1 RX2 (16) | purple | ☐ | ☐
4.17 | C41R28 | ESP #1 TX2 (17) | purple | ☐ | ☐
4.18 | C42R28 | ESP #1 D13 | purple | ☐ | ☐
4.19 | C43R28 | ESP #1 D14 | purple | ☐ | ☐
4.20 | C52R1 | ESP-CAM 5V | red | ☐ | ☐
4.21 | C52R2 | ESP-CAM GND | black | ☐ | ☐

✔ Each labelled end beeps to its pad and to nothing else on its neighbour list (section 8). Once everything is plugged, tape across each row of dupont ends so they can't work loose.

### Phase 5: cables and load cells · 25 min

Step | What | S | C
5.1 | Load cell A → HX711 A cell pads (E+ red, E− black, A− white, A+ green, or as in your photo). Strain-relieve the cable with tape or a tie. | ☐ | ☐
5.2 | Load cell B → HX711 B | ☐ | ☐
5.3 | Load cell C → HX711 C | ☐ | ☐
5.4 | R1 and R2 reader cables, 8 wires each, reader SDA on R22. Keep under 20 cm, GND wire alongside. | ☐ | ☐
5.5 | UI cable: LCD GND/VCC/SDA/SCL to pins 1–4; PAGE to pin 5, ACTION to pin 6; both buttons' other legs to the GND wire. | ☐ | ☐

✔ Each load cell: E+↔E− and A+↔A− each read about 350–1000 Ω. Open = broken wire or joint.

## 8. Inspection before power

- Joints are shiny cones; there are no balls or gaps.
- There are no bridges except the R1↔R2 ones and C3's two. Look at the board against a light.
- No wire clippings are on the board (shake it upside down).
- Capacitor stripes (−) are on GND.

Must be SILENT (a beep = short) | Why
5V ↔ GND · 3V3 ↔ GND · 5V ↔ 3V3 | supply or regulator short
C20R22 ↔ C21R22 (the two SDA) | both readers would answer at once
any two of R23, R24, R25, R28 (SCK, MOSI, MISO, RST) | SPI lines shorted
each HX711: R9 ↔ R10, and R9/R10 ↔ R8 or R11 | DT/SCK shorted or tied to power
UI pins 3↔4 (SDA/SCL), 5↔6 (PAGE/ACTION) | LCD or buttons merged

## 9. Power-up and tests

1. 5 V supply only, no ESPs plugged. 5V rail ≈ 5.0 V; 3V3 rail ≈ 0 V (ESP #1 feeds it). Nothing gets warm. Disconnect.
2. Plug ESP #1, USB only. The 3V3 rail reads ≈ 3.3 V. Open the serial monitor (command in section 6).
  - The LCD shows ShelfFlow sensor, then readings.
  - You see DIAG raw A=… B=… C=… … rc522=0xB2/0xB2 … lcd=ok, with no DISCONNECTED_, STUCK_ or SATURATED_ flags.
  - Press over each cell: only that cell's raw value jumps.
  - Tap a tag on R1, then R2: the scans= counters rise. The r1, r2 and both commands test each reader alone.
  - PAGE changes the LCD page; ACTION toggles the backlight.
3. Add the 5 V supply (USB stays). Same results.
4. Plug the ESP-CAM (IO0 jumper off). It joins "Shaun" within about 60 s. The DIAG values must not jump when its Wi-Fi starts.
5. Start the services (docs/local-hardware-integration.md). In the staff app, Device health shows sensor-1 recently seen.

## 10. Recalibration

The cells were re-soldered, so recalibrate:

1. Leave everything powered for 20 minutes to warm up.
2. Hold PAGE + ACTION for 3 s, then follow the LCD: empty, weight over A, B and C, verify, hold ACTION to save. The known mass is 44 g (set another with mass <g>).
3. Empty tray reads ≈ 0 g; the weight reads within ±2 g in the centre and at each corner, and holds for a minute.
4. Measure the support positions in mm and set the tray geometry in the staff app.

## 11. Troubleshooting

Symptom | Likely cause
ESP not on COM3 / reboot loop | Short on a rail (section 8), or C1 missing
DISCONNECTED_A/B/C | That HX711's DT/SCK wire (A: D32/D33, B: D25/D26, C: D34/D27), or its bus joint on R8/R11
STUCK_x / SATURATED_x | Cell wires: E± or A± open or swapped; compare with your photo
Weight goes the wrong way | A+/A− swapped. Harmless after recalibration
One reader 0x00 / 0xFF | Its own SDA wire (D21 or D4), or its cable
Both readers bad | A shared bridge or wire: D18/D23/D19/D22, or the block's GND/3V3
One reader picks up the other's tags | R22 (SDA) accidentally bridged
lcd=none | SDA/SCL swapped, no VCC, or the contrast trimmer
A button does nothing | Its second leg isn't on the GND wire, or the wrong pair of switch legs (beep while pressing)
Camera unreachable after power-up | IO0 jumper still on: remove it and press RST
Camera reboots when Wi-Fi starts | C2 missing, or thin 5V/GND wires
Grams drift | Warm-up (20 min), or cell A's mounting

## 12. Tick list

Step | Joint | S | C
3.1 | Rails R1 5V, R2 GND, R3 3V3 | ☐ | ☐
3.2 | J0 to the rails | ☐ | ☐
3.3 | HX711 GND bus R8 | ☐ | ☐
3.4 | HX711 VCC bus R11 | ☐ | ☐
3.5 | GND bus → GND rail | ☐ | ☐
3.6 | VCC bus → 3V3 rail | ☐ | ☐
3.7 | Six R1↔R2 bridges (not R22, R26) | ☐ | ☐
3.8 | C3 | ☐ | ☐
3.9 | RC522 GND → rail | ☐ | ☐
3.10 | RC522 3V3 → rail | ☐ | ☐
3.11 | UI GND → rail | ☐ | ☐
3.12 | UI VCC → rail | ☐ | ☐
3.13 | C1 | ☐ | ☐
3.14 | C2 | ☐ | ☐
4.1 | ESP #1 VIN (red) | ☐ | ☐
4.2 | ESP #1 GND (black) | ☐ | ☐
4.3 | ESP #1 3V3 (orange) | ☐ | ☐
4.4 | ESP #1 D32 (green) | ☐ | ☐
4.5 | ESP #1 D33 (white) | ☐ | ☐
4.6 | ESP #1 D25 (green) | ☐ | ☐
4.7 | ESP #1 D26 (white) | ☐ | ☐
4.8 | ESP #1 D34 (green) | ☐ | ☐
4.9 | ESP #1 D27 (white) | ☐ | ☐
4.10 | ESP #1 D18 (blue) | ☐ | ☐
4.11 | ESP #1 D23 (blue) | ☐ | ☐
4.12 | ESP #1 D19 (blue) | ☐ | ☐
4.13 | ESP #1 D22 (grey) | ☐ | ☐
4.14 | ESP #1 D21 (yellow SS1) | ☐ | ☐
4.15 | ESP #1 D4 (yellow SS2) | ☐ | ☐
4.16 | ESP #1 RX2 (16) (purple) | ☐ | ☐
4.17 | ESP #1 TX2 (17) (purple) | ☐ | ☐
4.18 | ESP #1 D13 (purple) | ☐ | ☐
4.19 | ESP #1 D14 (purple) | ☐ | ☐
4.20 | ESP-CAM 5V (red) | ☐ | ☐
4.21 | ESP-CAM GND (black) | ☐ | ☐
5.1–5.3 | Load cells A, B, C | ☐ | ☐
5.4 | Reader cables | ☐ | ☐
5.5 | UI cable | ☐ | ☐

Generated by tools/perfboard_guide.py from the same data as the schematic. 42 pads are used by parts; every bare wire was checked so it never touches a pad of another net.
