rohitvijayakumar45/ShelfFlow/reports/installed-python.txt

ajsonrpc==1.2.0
alembic==1.15.2
annotated-types==0.8.0
anyio==4.15.1
bottle==0.13.4
certifi==2026.7.22
charset-normalizer==3.5.2
click==8.1.7
colorama==0.4.6
coverage==7.16.2
fastapi==0.115.12
greenlet==3.5.6
h11==0.16.0
httpcore==1.0.9
httptools==0.8.0
httpx==0.28.1
idna==3.20
iniconfig==2.3.1
Mako==1.4.3
MarkupSafe==3.0.4
marshmallow==3.26.2
numpy==2.2.5
opencv-python==4.11.0.86
packaging==26.3
paho-mqtt==2.1.0
platformio==6.1.18
pluggy==1.6.0
psycopg==3.2.9
psycopg-binary==3.2.9
pydantic==2.11.4
pydantic_core==2.33.2
pyelftools==0.33
PyJWT==2.10.1
pyserial==3.5
pytest==8.3.5
pytest-cov==6.1.1
python-dotenv==1.1.0
PyYAML==6.0.3
redis==5.2.1
requests==2.34.2
rq==2.3.2
semantic-version==2.10.0
# Editable install with no version control (shelfflow==0.1.0)
-e c:\users\rohit\projects\shelfflow
SQLAlchemy==2.0.40
starlette==0.46.2
tabulate==0.10.0
typing-inspection==0.4.4
typing_extensions==4.16.0
tzdata==2026.5
urllib3==2.8.0
uvicorn==0.34.2
watchfiles==1.3.0
websockets==17.2
wsproto==1.3.2
