rohitvijayakumar45/ShelfFlow/firmware/camera/include/api_check.h

#pragma once
// Compile-test sentinels only: these are NOT wiring assignments.
// CAMERA_API_CHECK startup never calls the driver or drives any camera pins.
#define BOARD_CONFIRMED 1
#define CAM_D0 -1
#define CAM_D1 -1
#define CAM_D2 -1
#define CAM_D3 -1
#define CAM_D4 -1
#define CAM_D5 -1
#define CAM_D6 -1
#define CAM_D7 -1
#define CAM_XCLK -1
#define CAM_PCLK -1
#define CAM_VSYNC -1
#define CAM_HREF -1
#define CAM_SDA -1
#define CAM_SCL -1
#define CAM_PWDN -1
#define CAM_RESET -1
