rohitvijayakumar45/ShelfFlow/(commit log)

2026-10-11 feat: add ShelfFlow smart-store prototype
    Add customer and staff apps, sensor fusion, firmware, and simulation.
    Apply Alembic migrations before starting the backend. Physical ownership
    remains review-first until camera wiring, models, and trials are verified.
2026-10-12 Audit fixes and step-by-step camera programming via spare ESP32
    - Backend: best-effort HEALTH events no longer advance the per-boot
    ordering watermark, so queued sensor flush barriers can be acknowledged
    (regression tests added).
    - Firmware queue sends the lowest queued sequence first instead of
    lexicographic LittleFS order.
    - Vision Mode B switches resolution only on state change and never
    crashes on a failed switch.
    - Camera: esp32cam-identify and esp32cam-pinmap-probe environments; the
    AI-Thinker candidate map is accepted only after OV3660 PID + JPEG
    readback. Server prints its IP. Uploads use 115200, no_reset.
    - Shelf controller prints 1 Hz DIAG raw HX711 / RC522 / RFID outpu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
2026-10-15 Camera MJPEG stream, capture transports, bench sketches and first measurements
    - Camera firmware: authenticated MJPEG stream on port 81 in its own task
    (per-part sequence/boot/capture headers), Wi-Fi power save off, health
    reports RSSI, channel, uptime and stream clients.
    - vision.capture: poll or stream transport with multipart reassembly and
    reconnect; --transport option in benchmark and runner; stream tests.
    - Shelf controller: devkitc-v4-offline bench build (Wi-Fi off) to isolate
    sensor wiring from supply brownouts.
    - Bench sketches: standalone OV3660 AP preview and HX711 weight test.
    - Reports: first physical OV3660 frames and poll/stream benchmarks on the
    confirmed AI-Thinker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
2026-10-15 Mixed-product trays tracked per physical unit
    - tray_units / tray_loads (migration 0008): each unit weighed from a settled,
    healthy, current-calibration tray WEIGHT event during an audited staff
    loading session; the event is claimed so it cannot count as a pickup.
    - evaluate_units: weight change matched against units on the tray or in the
    shopper's cart (unique product combination, up to 3 units), then the
    vision verdict and emptied spot; explicit vetoes for no match, ambiguity,
    vision conflict, quantity, spot, owner/product, zero net and direction.
    - Unit moves are atomic with cart/inventory; review and corrections name
    unit_ids; staff APIs for tracking mode, loading, weight eve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
2026-10-21 Shelf controller: tripod load cells, LCD, service buttons, dual RC522, USB queue
2026-10-21 Camera firmware streaming, USB bridge and local hardware tools
2026-10-21 Backend: tripod positions, device calibration, few-shot references, wrong-tray returns
2026-10-21 Backend: learning loop, analytics, review suggestions, evidence timeline
    - Uncertain crops queue (migration 0011): staff answers become STAFF_LABEL references.
    - Recognition threshold tuning from staff-reviewed samples; staff apply explicitly and
    vision reads the values from its config.
    - KPIs, shrink/misplacement report and scale drift check (scale vs recorded units).
    - Suggested review decision, evidence timeline (weights, taps, annotated frames).
    - Candidates carry recognition scores; events carry model_versions. Event replay
    ignores empty fields added after the stored copy.
    - Customer cart: product thumbnails and event times.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
2026-10-21 Vision: motion proof, swappable embedders, masking, cues, privacy
    - MotionProof links hand contact, item exit/arrival and the bracelet marker next to
    that hand; item detector may carry a second class 'hand'.
    - Embedders: DINOv2 small/base, SigLIP 2, CLIP, DINOv3 (when loadable); GrabCut/SAM
    background masking recorded in the gallery; colour cue for near-ties.
    - Reference quality gate for restock and teach crops; uncertain-crop queue.
    - Face redaction for stored evidence frames; per-frame annotations kept for review.
    - Tools: embedder benchmark, model replay against staff decisions, hand-class dataset
    support and MediaPipe hand pre-labelling. Docs: docs/model-pipeline.md.
    Co-Authored-B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
2026-10-21 Apps: insights, help the camera, evidence player, shelf map, cart notices
    Staff: Insights page (KPIs, threshold recommendation, scale health, shrink), active
    learning cards, evidence player with overlays and weight timeline, suggested review
    decisions, live tripod shelf map, drift alerts. Customer: product thumbnails, added /
    put back notices with a 'Not mine?' dispute shortcut, exit summary.
2026-10-24 Shelf: two 10 kg cells, step-hold weighing, quick calibration, teach capture
    Shelf controller (A/C only, cell B removed):
    - Two-cell layout with new NVS calibration keys, 9 kg overload limit, single
    devkitc-v4-usb-integration build with the weighing self-test at boot.
    - HX711 glitch filter: isolated corrupt reads are dropped and counted.
    - Quick calibration (empty, 44 g over A, over C, centre, empty) with a
    least-squares fit that removes drift before solving the gains.
    - Step-hold weighing: re-tare to the held weight every 2 s while settled,
    items are settled steps of 3 g or more, empty tray snaps to 0.
    - Queue index, RFID timing and diagnostics from 24 Oct.
    Backend, vision and apps: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
2026-10-25 Manual capture with SAM review, handoff updates, camera diagnostics logs
    - Products & recognition: capture the latest fresh camera frame on demand, draw or type
    the product box, review a SAM cut-out and save it as a reference (migration 0013).
    - docs/manual-capture.md; HANDOFF and README updated; local_app wiring.
    - reports/camera-serial.log and camera-watch.jsonl from the camera brownout investigation.
2026-10-25 Train products: video capture, SAM 2.1 boxes, YOLO26n training
    - Train products page in the staff app: record every camera frame of a clip
    (raw JPEG, no re-encode), mark the product once, SAM 2.1 video tracking
    boxes every frame, blur/odd-box auto-exclusion with manual override,
    YOLO26n fine-tuning with live progress/stop, live model test, activation.
    - tools/trainer.py: local GPU service behind the staff app's /trainer proxy,
    staff JWT auth; `tools.local_app trainer` starts it on the raw camera proxy.
    - vision/training.py: sharpness scoring, SAM labelling, chunked train/val
    split, training subprocess with progress.json and clean stop.
    - local_app vision uses an activated YOLO26n p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
2026-10-25 Staff app: simpler navigation, live camera, compact review queue
    - Grouped sidebar (Daily / Products / Advanced) with 8 plainly named pages
    instead of 10; camera, shelf-controller and review-count status chips in
    the header on every page; one-line purpose under each page title.
    - Home: clickable status tiles, live camera, quick actions, alerts, taps.
    - Live camera page: real MJPEG video (with detections or original) through
    a new authenticated /staff/camera/stream proxy (~11 fps, was one still
    every 2 s), what the camera sees, tray weight and bracelet taps.
    - Review queue: compact list beside a decision panel, newest first, filters,
    previous/next, and bulk dismiss with one audited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
2026-10-25 Review queue with snapshots and one-tap decisions; trained model in live view
    - Review queue: each item shows a snapshot of the doubted object; the clip
    plays at once (frames load in parallel, middle frame first); product
    buttons with photos (camera guess marked), movement and shopper are one
    tap; Enter records, D dismisses, arrows move; auto-advance after each.
    - /staff/state review items carry their snapshot and frame count;
    /staff/product-image for staff (catalogue and review product buttons).
    - Catalogue shows product photos.
    - detector_preview uses the model switched on in Train products
    (SHELFFLOW_DETECTOR=gallery keeps the DINOv2 gallery).
    - SAM labelling at 640 px: 3x faste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
2026-10-25 Training: never crash on the Windows progress-file lock; train at frame size
    - write_json retries when a reader briefly holds progress.json (Windows
    PermissionError on replace), and progress reporting can no longer stop
    a training run (a run failed at epoch 4 this way).
    - Train at the recorded frames' own size (320 for the OV3660 stream), batch
    32: epochs went from ~15 s to 2-4 s on the RTX 4050, 99.5% mAP50 on a real
    clip. The detector preview predicts at the model's training size.
    - Up to 250 frames per clip (near-duplicates at 11 fps) and no mid-run
    close_mosaic dataloader rebuild (~35 s on Windows).
2026-10-25 Training page: clear model, run and recording status; live view follows model
    - "Model in use" banner (when trained, on which products, accuracy, when it
    was switched on); recordings in that model are marked.
    - Training runs: readable times, status (training now / finished / stopped
    early, model kept / stopped before the first epoch / failed), epochs done,
    which recordings went in, delete button; Use this model applies at once.
    - Stop during start-up kills the run immediately instead of waiting for the
    first batch; a run stopped after some epochs keeps its best checkpoint.
    - Activation swaps models/trained/active.pt atomically and the detector
    preview reloads it within ~3 s (no res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
2026-10-25 Model lineage, Unknown check, shop workflow part 1, 26 Oct handoff
    - Train page: each new model builds on the model in use and keeps its
    products (inherited dataset frames + warm-start weights); Stop using;
    free epoch input; bracelet bands recordable as classes.
    - Unknown check (vision/verify.py): DINOv2 references from each model's
    own training frames; used in live view, Test live and the shop.
    - Strict AUTO_ADD (off by default), bands as bracelet markers 200/201,
    QR + tap check-in, bracelet patterns, staff exit backend.
    - Import tool for the earlier pilot frames.
    - docs/HANDOFF-2026-10-26.md: full state, pending work, camera issues.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
